genrnd/figa-pi.hw/README.md

figa-pi
======

figa-pi -- expansion board (HAT, hardware attached top) for Raspberry
PI with FPGA and 1G ethernet port.

Open hardware poject, made with Kicad.

Authors
-------

General RnD LLC, 2018, http://genrnd.com
