genrnd/figa-pi.hw/out/bom/figa-pi_bom.xls

Num | MF | MFPN | DESC | CAT | CASE | Quantity | Reference
1 | Yageo | CC0603KRX7R9BB104 | CAP CER 0.1UF 50V X7R 0603 | CAP | C0603 | 41 | C1 C10 C11 C12 C13 C14 C15 C16 C17 C18 C19 C2 C20 C21 C25 C3 C35 C36 C38 C39 C4 C41 C42 C43 C44 C45 C46 C47 C48 C5 C54 C56 C58 C60 C61 C63 C65 C66 C7 C8 C9
2 | Yageo | CC0603KRX5R7BB106 | CAP CER 10UF 16V X5R 0603 | CAP | C0603 | 14 | C22 C23 C24 C26 C27 C28 C29 C33 C34 C37 C40 C6 C62 C64
3 | Yageo | CC0603MRX5R6BB226 | CAP CER 22UF 10V X5R 0603 | CAP | C0603 | 3 | C30 C31 C32
4 | Yageo | CC0603KRX7R9BB103 | CAP CER 10000PF 50V X7R 0603 | CAP | C0603 | 7 | C49 C50 C52 C53 C55 C57 C59
5 | Ningbo connfly electronic | BH-10(IDC-10MS) | SHROUDED CONN TH 2x5pin 2.54mm | CONN | PIN_HEADER_SHR_2x5_2.54mm | 1 | J1
6 | Ningbo connfly electronic | PLS-2 | CONN TH 1x2pin 2.54mm | CONN | PIN_HEADER_1x2_2.54mm | 1 | J2
7 | Ningbo connfly electronic | PBD-40(DS1023-2x20) | CONN SOCKET TH 2x20pin 2.54mm | CONN | SOCKET_2x20_2.54mm | 1 | J3
8 | Ningbo connfly electronic | PLD-10(DS1021-2x5) | CONN TH 2x5pin 2.54mm | CONN | PIN_HEADER_2x5_2.54mm | 1 | J4
9 | Bel Fuse Inc | L829-1J1T-43 | CONN MAGJACK 1PORT 1000 BASE-T | CONN | L829_RJ45 | 1 | J5
10 | Ningbo connfly electronic | PBD-4 (DS1023-2X2) | CONN SOCKET TH 2x2pin 2.54mm | CONN | SOCKET_2x2_2.54mm | 1 | J6
11 | Murata Electronics | BLM21PG300SN1D | FERRITE BEAD 30 OHM 0805 1LN | IND | L0805 | 3 | L10 L11 L12
12 | Murata Electronics | BLM18PG330SN1D | FERRITE BEAD 33 OHM 0603 1LN | IND | L0603 | 10 | L1 L13 L14 L15 L16 L2 L3 L4 L5 L6
13 | Murata Electronics | LQH3NPN1R0MJRL | FIXED IND 1UH 1.62A 40 MOHM SMD | IND | L1212 | 3 | L7 L8 L9
14 | Yageo | RC0603FR-073K92L | RES SMD 3.92K OHM 1% 1/10W 0603 | RES | R0603 | 2 | R11 R12
15 | Yageo | RC0603FR-071KL | RES SMD 1k OHM 1% 1/10W 0603 | RES | R0603 | 7 | R10 R13 R18 R19 R20 R42 R8
16 | Yageo | RC0603FR-07390RL | RES SMD 390R OHM 1% 1/10W 0603 | RES | R0603 | 6 | R1 R2 R3 R4 R5 R6
17 | Yageo | RC0603FR-074K99L | RES SMD 4.99K OHM 1% 1/10W 0603 | RES | R0603 | 3 | R21 R22 R24
18 | Yageo | RC0603FR-07220RL | RES SMD 220R OHM 1% 1/10W 0603 | RES | R0603 | 2 | R28 R29
19 | Yageo | RC0603FR-07127KL | RES SMD 127k OHM 1% 1/10W 0603 | RES | R0603 | 1 | R30
20 | Yageo | RC0603FR-07178KL | RES SMD 178k OHM 1% 1/10W 0603 | RES | R0603 | 1 | R32
21 | Yageo | RC0603FR-0728KL | RES SMD 28k OHM 1% 1/10W 0603 | RES | R0603 | 3 | R31 R33 R35
22 | Yageo | RC0603FR-0746K4L | RES SMD 46.4k OHM 1% 1/10W 0603 | RES | R0603 | 1 | R34
23 | Yageo | RC0603FR-0733RL | RES SMD 33R OHM 1% 1/10W 0603 | RES | R0603 | 5 | R36 R37 R38 R39 R40
24 | Yageo | RC0603FR-0710KL | RES SMD 10k OHM 1% 1/10W 0603 | RES | R0603 | 10 | R14 R15 R16 R17 R23 R25 R26 R27 R7 R9
25 | Microchip Technology | 24LC32A/SN | IC EEPROM 32KBIT 400KHZ 8SOIC | IC | SOIC-8 | 1 | U1
26 | Texas Instruments | TLV62084DSGR | IC REG BUCK ADJ 2A SYNC 8WSON | IC | WSON-8 | 3 | U10 U11 U9
27 | Abracon LLC | ASEMB-25.000MHZ-LC-T | OSC MEMS 25.000MHZ CMOS SMD | IC | 4-SMD, No Lead | 1 | U2
28 | ON Semiconductor | NUP4114UPXV6T1G | TVS DIODE 5.5V 10V SOT563 | DIODE | SOT-563 | 1 | U3
29 | Intel | 10CL025ZE144 | FPGA | IC | QFP-144 | 1 | U5
30 | Microchip Technology | KSZ9021GN | IC TXRX ETHERNET 64QFN | IC | QFN-64 | 1 | U6
31 | Texas Instruments | CDCLVC1102PW | IC CLK BUFFER 1:2 250MHZ 8TSSOP | IC | TSSOP-8 | 1 | U7
32 | Kingbright | KP-1608SGC | SMD LED 0603 GREEN | DIODE | LED0603 | 3 | VD2 VD4 VD6
33 | Kingbright | KP-1608SRC | SMD LED 0603 RED | DIODE | LED0603 | 3 | VD1 VD3 VD5
