genrnd/figa-pi.hw/out/sch/figa-pi-sch.pdf

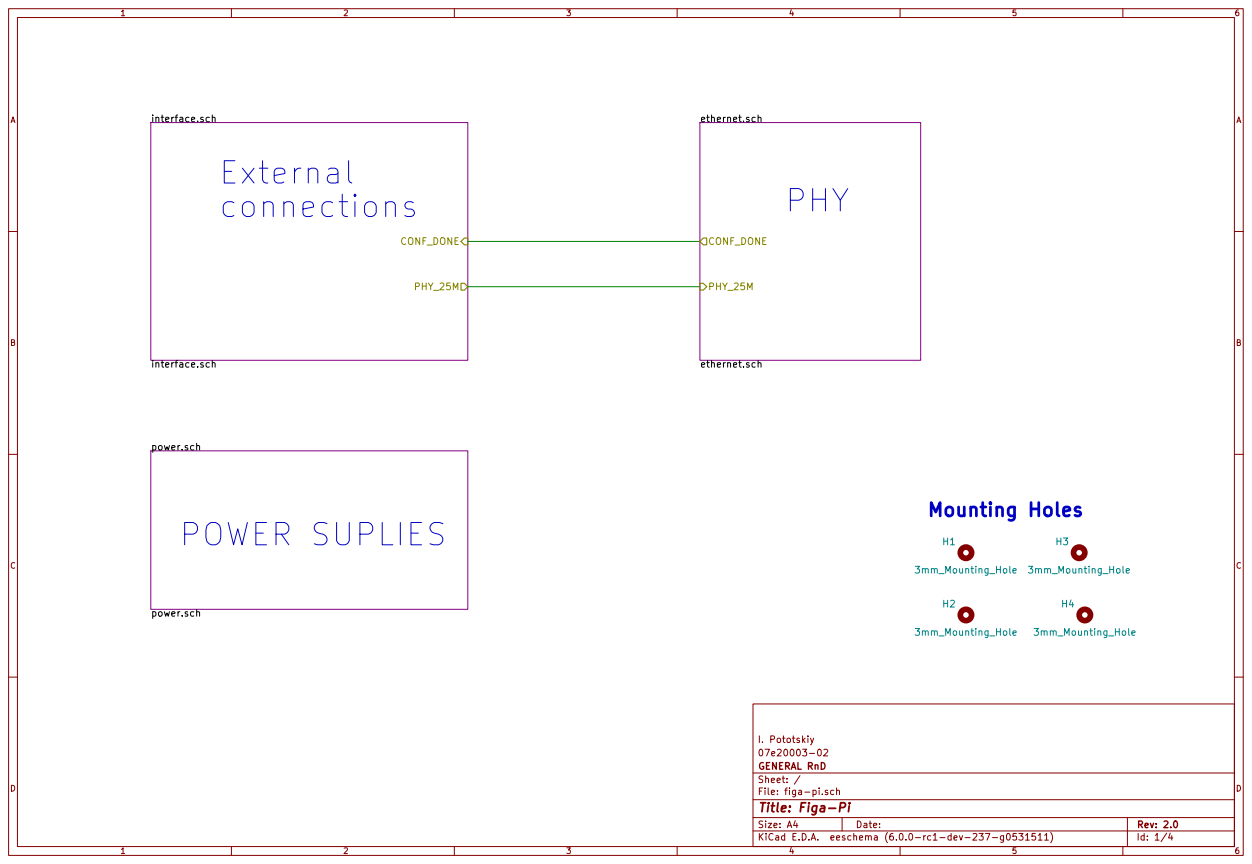
[picture p1: page 1]

File: figa-pi.sch Sheet: / GENERAL RnD

Id: 1/4 Title: Figa-Pi

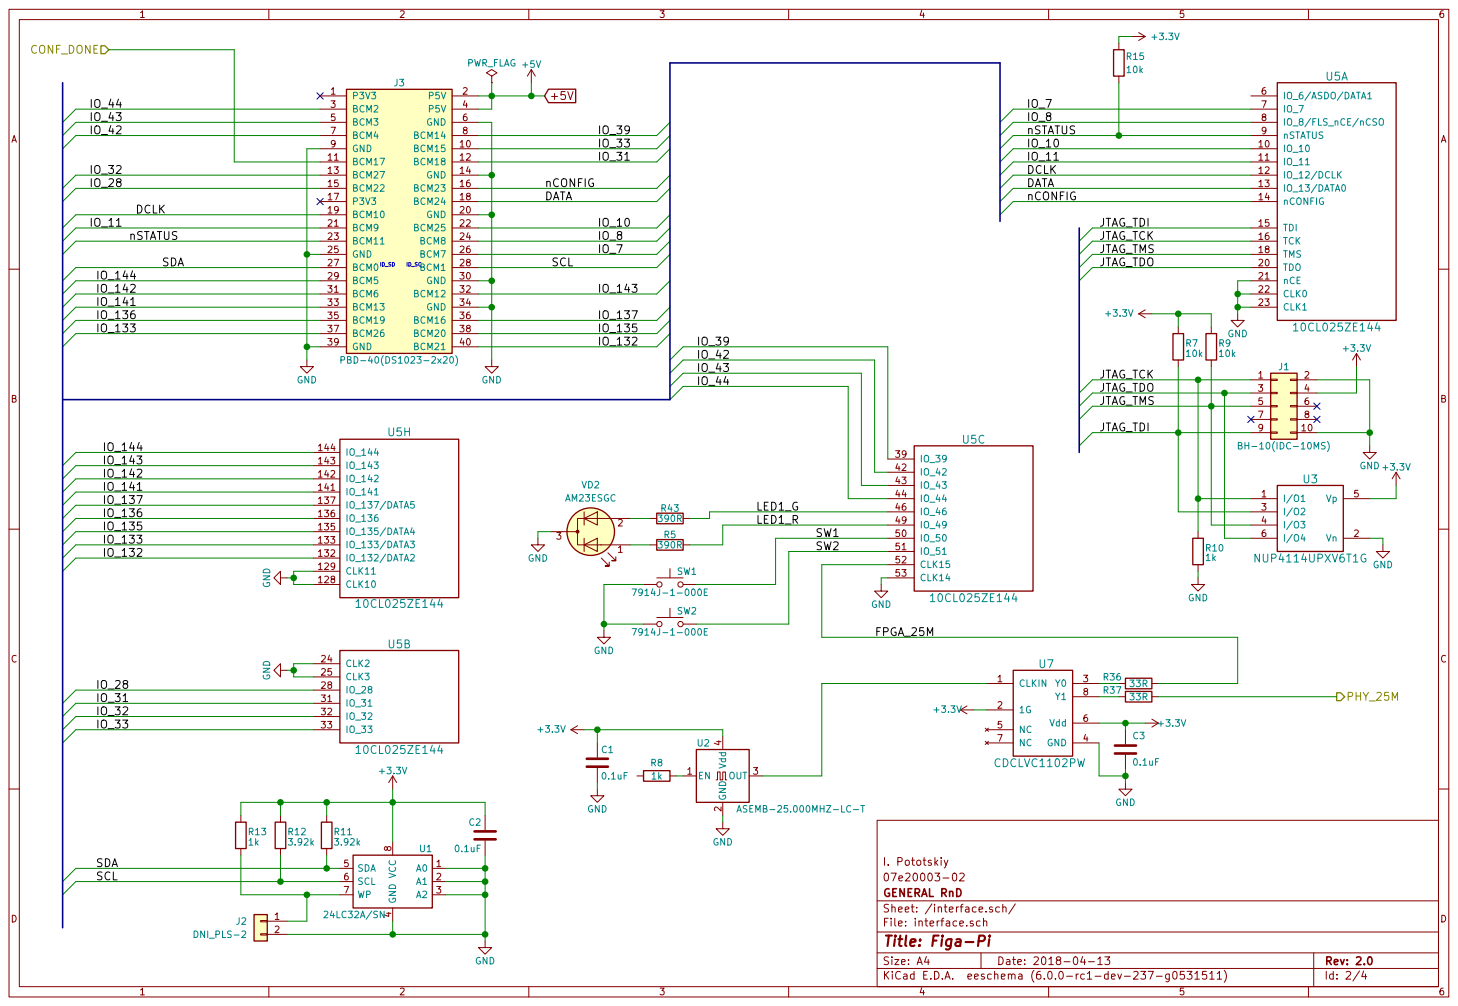
[picture p2: page 2]

IO_33 | IO_10
IO_31 | IO_11 | IO_11 11

IO_8
IO_7

IO_135
IO_132

J1 BH-10(IDC-10MS) GND GND

2 OUT 3 Vdd U2 4 ASEMB-25.000MHZ-LC-T R8

I. Pototskiy
Id: 2/4 Title: Figa-Pi File: interface.sch Sheet: /interface.sch/ GENERAL RnD

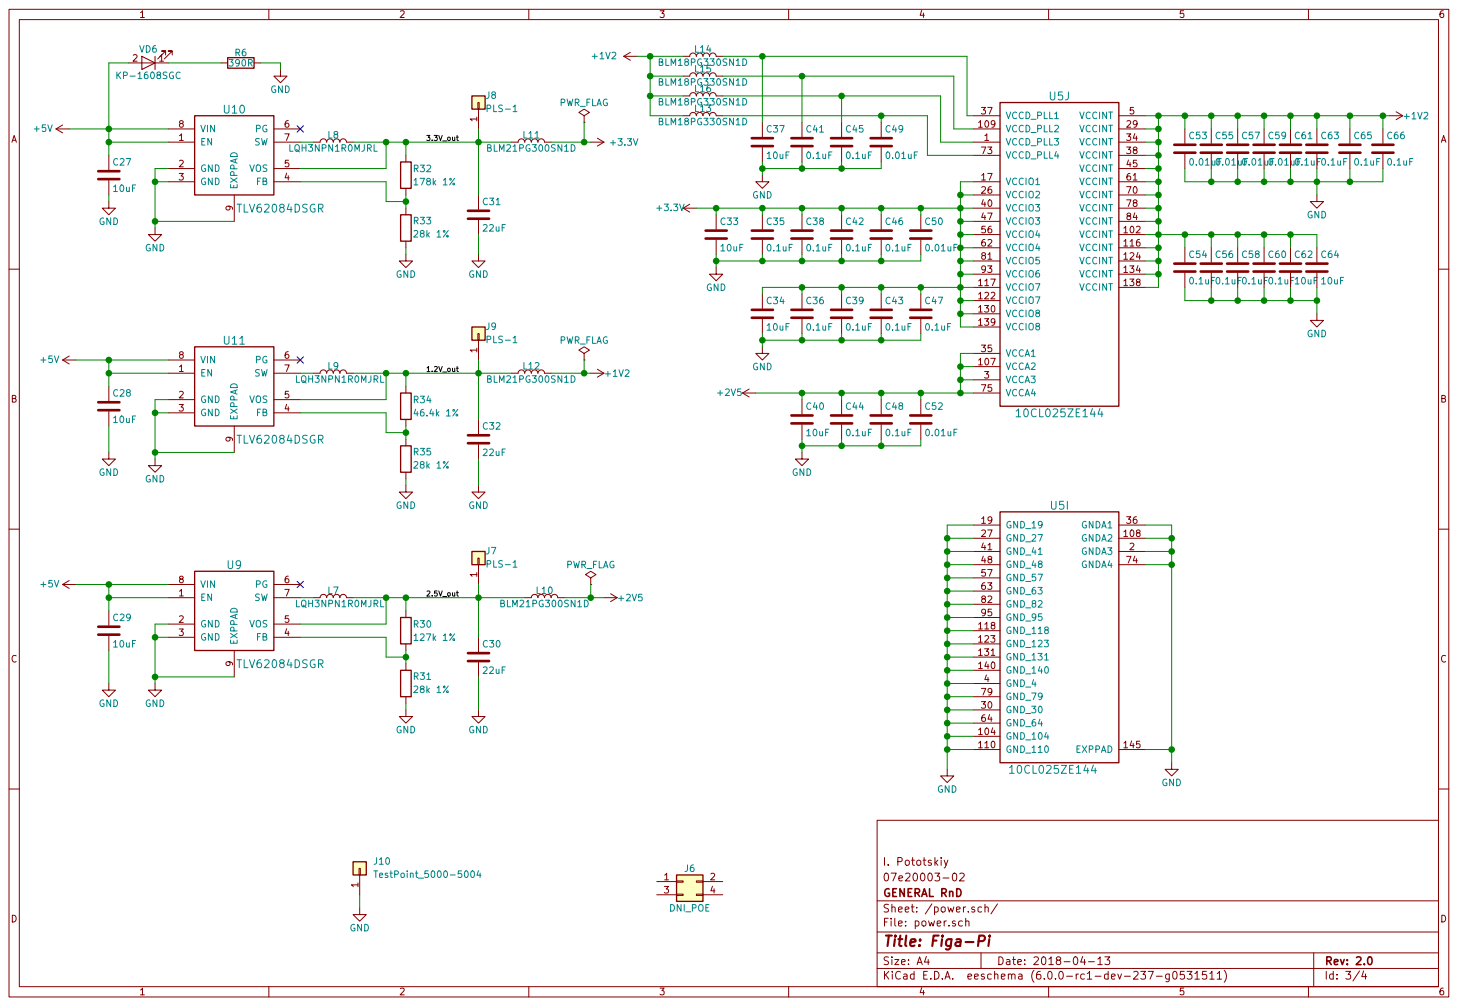
[picture p3: page 3]

Sheet: /power.sch/ GENERAL RnD

File: power.sch
Id: 3/4 Title: Figa-Pi

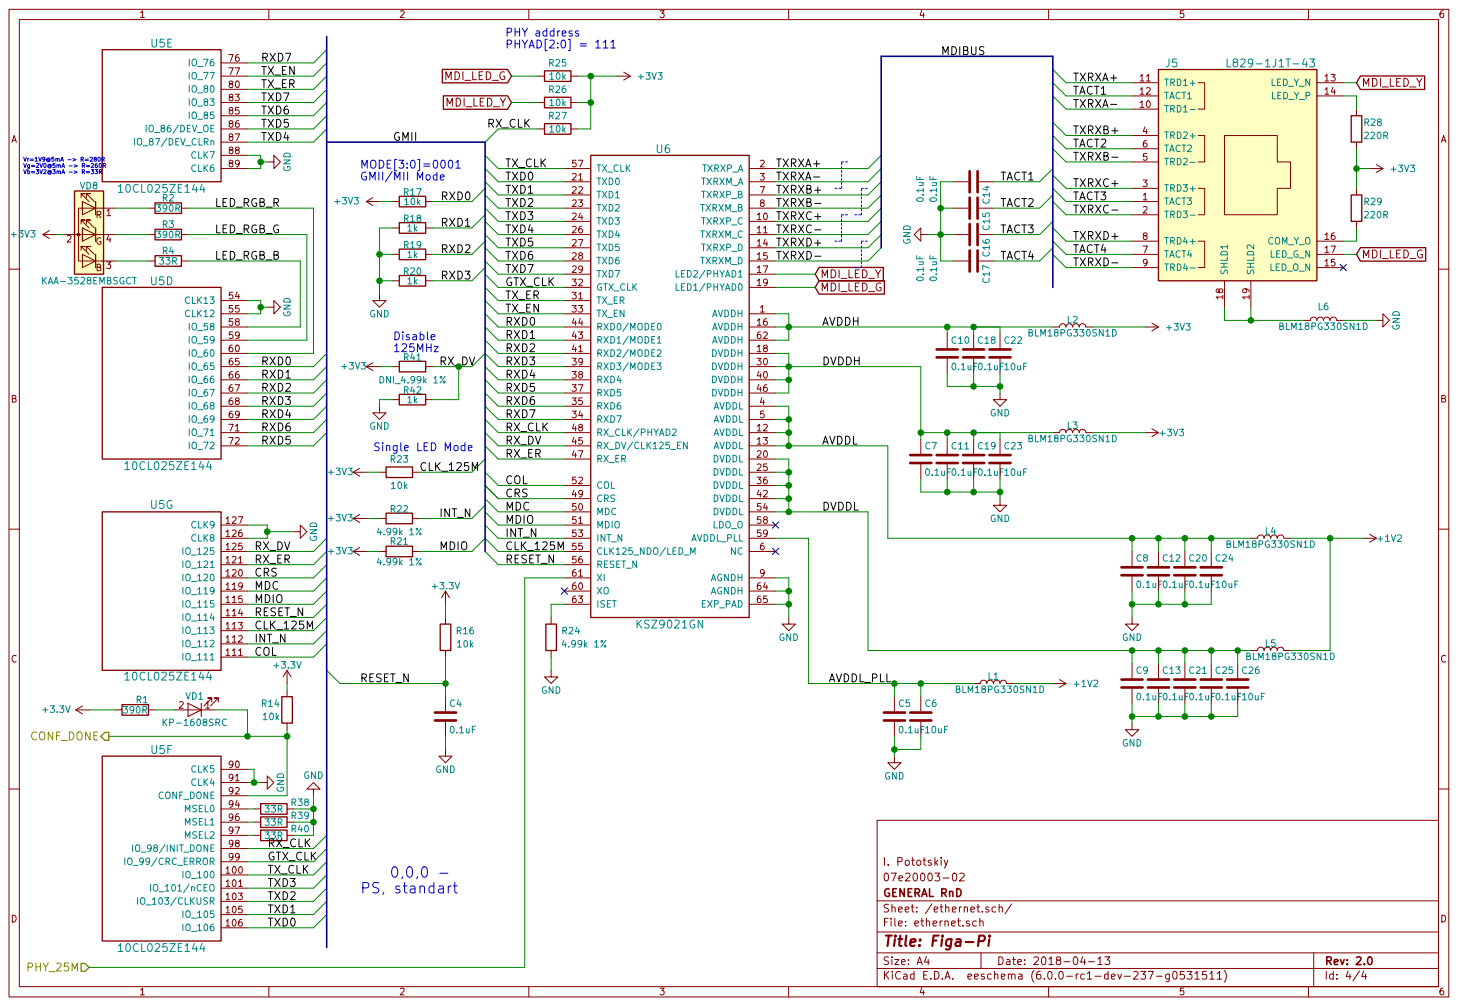
[picture p4: page 4]

TXRXA+ TXRXA- TXRXB+ TXRXB- TXRXC+

I. Pototskiy
Id: 4/4 Title: Figa-Pi File: ethernet.sch Sheet: /ethernet.sch/ GENERAL RnD
