genrnd/figa-pi.hw/out/assy/figa-pi-assy_bot.pdf

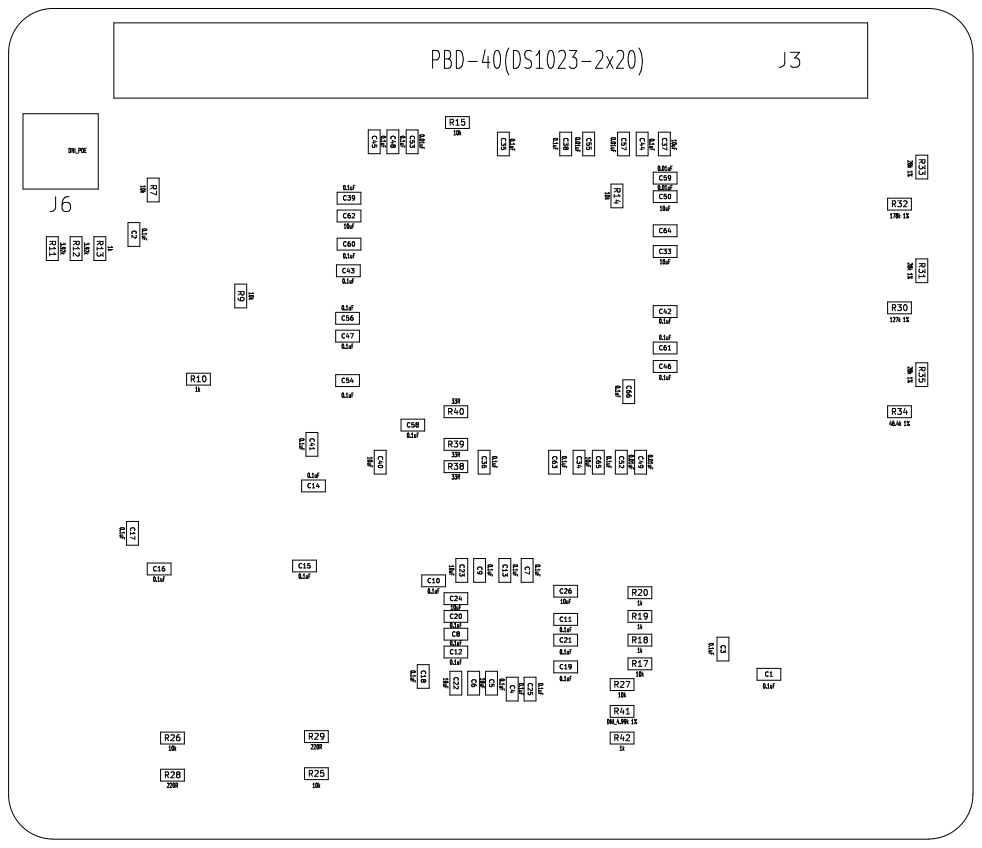
[picture p5: page 1]
