genrnd/figa-pi.hw/out/assy/figa-pi-assy_top.pdf

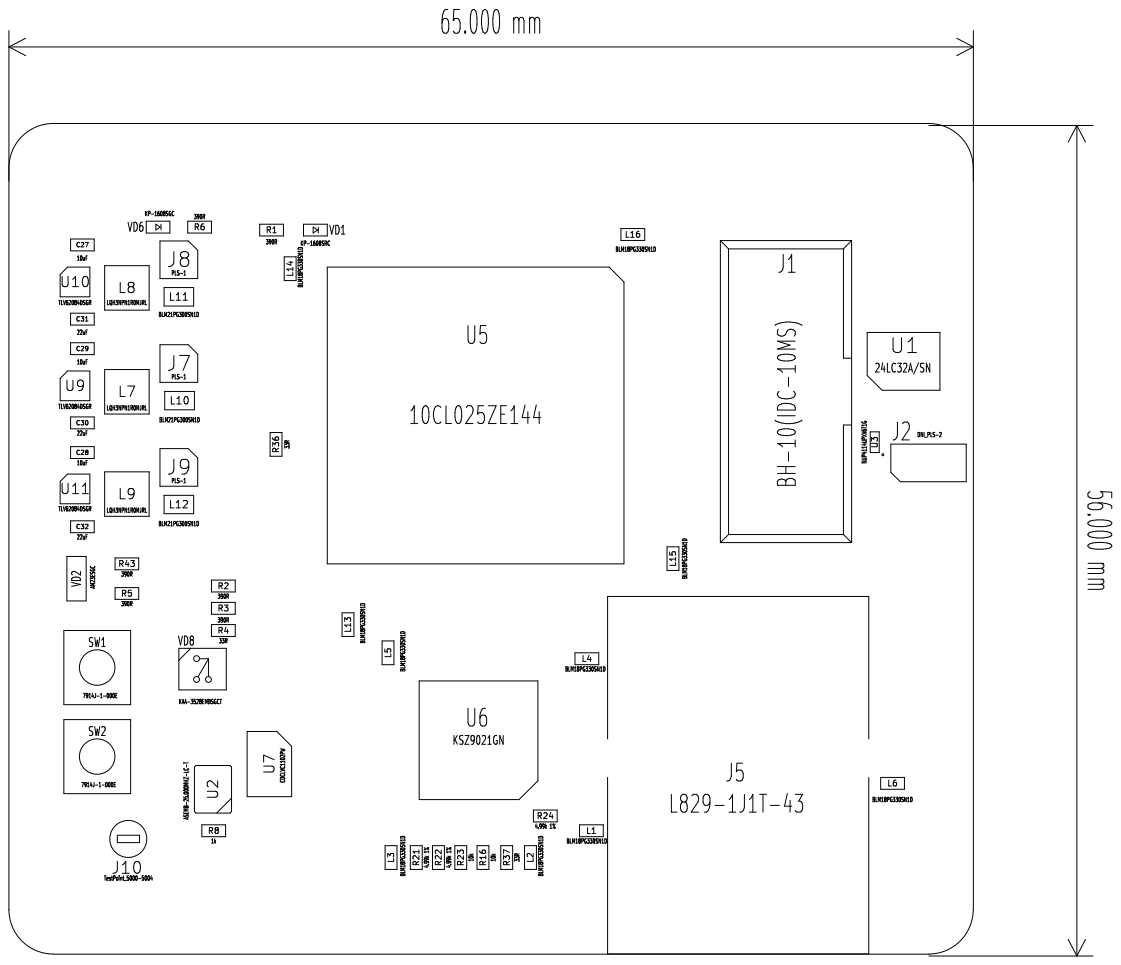
[picture p6: page 1]
