genrnd/figa-pi.hw/(commit log)

2018-04-04 add kicad folder
2018-04-04 init project
    [fpgagigepi.kicad_pcb, fpgagigepi.sch]
2018-04-06 add components to library. start electric schematic
    [ethernet.sch, interface.sch, power.sch]
2018-04-13 add ksz9021gn, cfps-73 to library
    [ethernet.sch, fpgagigepi.sch, interface.sch, power.sch]
2018-04-16 add tlv62080 to library, continue design schematic
    [ethernet.sch, fpgagigepi.sch, interface.sch, power.sch]
2018-04-17 add nb3l553dr2g to library, continue design schematic
    [ethernet.sch, fpgagigepi.sch, interface.sch, power.sch]
2018-04-18 continue design schematic
    [ethernet.sch, interface.sch, power.sch]
2018-04-20 finished electrical connections
    [ethernet.sch, interface.sch, power.sch]
2018-05-22 write nominal of components
    [ethernet.sch, fpgagigepi.kicad_pcb, interface.sch, power.sch]
2018-05-23 place components to pcb, add footprints of cfps-73 l829 sot-563
    [ethernet.sch, fpgagigepi.kicad_pcb, interface.sch, power.sch]
2018-05-24 add modeles to 3d render
    [ethernet.sch, fpgagigepi.kicad_pcb, interface.sch, power.sch]
2018-05-25 remove CR (carriage return) from README
2018-05-29 Project translated to template "Raspberry Pi HAT" Added library files from template. Renamed refdes. Changed placement for all components
    [ethernet.sch, fpgagigepi.kicad_pcb, fpgagigepi.sch, interface.sch, power.sch]
2018-05-30 Update path to 3d models for components in local library (add ${KIPRJMOD}/packages3d/)
    [fpgagigepi.kicad_pcb]
2018-06-01 Schematics updated for correct BOM generation Corrected RefDes (not renumbered yet) PCB updated (not routed) Added 3d models for new components Added folder assy (empty) Added folder bom Added BOM fi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
    [ethernet.sch, fpgagigepi.kicad_pcb, interface.sch, power.sch]
2018-06-05 Corrected path for schematics Renumbered components Remaped GMII connections to other banks PCB updated - final placement for major components and some conn routed Corrected 3d models Add text Cyclon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
    [BOM_fpgagigepi.xls, ethernet.sch, fpgagigepi.kicad_pcb, fpgagigepi.sch, interface.sch, power.sch]
2018-06-06 Replaced clock buffer NB3L553DR2G to cdclvc1102 Added datasheet for cdclvc1102 Added components cdclvc1102pw in library_cache Remaped cyclone-to-40-pin-header connections Updated schematics Updated P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
    [BOM_fpgagigepi.xls, ethernet.sch, fpgagigepi.kicad_pcb, interface.sch, power.sch]
2018-06-08 rename project files to figa-pi and internal text replaced to figa-pi
    [ethernet.sch, figa-pi.kicad_pcb, figa-pi.sch, interface.sch, power.sch]
2018-06-08 Added LOGO as footprint Added fields for all components Renamed BOM file. Updated BOM file. Updated project fields.
    [BOM_fpgagigepi.xls, ethernet.sch, figa-pi.kicad_pcb, figa-pi.sch, figa-pi_bom.xls, interface.sch, power.sch]
2018-06-09 Removed datasheet for unused components Removed library for single components Create common symbol library for project figa-pi.lib Updated path to new symbol library
    [ethernet.sch, figa-pi.sch, interface.sch, power.sch]
2018-06-09 Removed footprint for unused components Updated 3d model for LQFP-144 Updated symbol library Updated schematics Updated PCB - finished routing
    [ethernet.sch, figa-pi.kicad_pcb, figa-pi.sch, interface.sch, power.sch]
2018-06-10 add board name to pcb (figa-pi), move board number and correct company name
    [figa-pi.kicad_pcb]
2018-06-10 remove company name. url is more than enough
    [figa-pi.kicad_pcb]
2018-06-13 Added logo as 2 footprints Corrected RefDes dimensions and placement on silk layers
    [figa-pi.kicad_pcb]
2018-06-13 Updated Logo footprint Updated PCB with new footprint
    [figa-pi.kicad_pcb]
2018-06-19 Updated BOM file Added footprint for Logo
    [figa-pi_bom.xls]
2018-06-19 Updated PCB for manufacturing Created assembly drawings (without title) Created gerbers and drilling files
    [figa-pi-B.Cu.gbr, figa-pi-B.Mask.gbr, figa-pi-B.Paste.gbr, figa-pi-B.SilkS.gbr, figa-pi-Edge.Cuts.gbr, figa-pi-F.Cu.gbr, figa-pi-F.Mask.gbr, figa-pi-F.Paste.gbr]
2018-06-20 Updated PCB for manufacturer "Rezonit" tech parameters Updated gerber and drill files Updated assembly drawing files Created mf_pcb folder Added files for manufacturer "Rezonit"
    [Rezonit_blank.xls, StackUp_4Layers.xls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]
2018-06-21 Replaced L7,L8,L9 (LQH3NPN1R0NJ0 - obsolete) with LQH3NPN1R0MJRL Updated project files Updated BOM file
    [figa-pi.kicad_pcb, figa-pi_bom.xls, power.sch]
2018-06-22 Updated top silk layer with power signals marking Updated one gerber file figa-pi-F.SilkS.gbr
    [figa-pi.kicad_pcb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]
2018-06-25 add schematic pdf to repo
2018-07-24 Updated footprint and 3D model for ksz9021gn (it was wrong)
    [ethernet.sch, figa-pi.kicad_pcb]
2018-07-27 Add datasheets for new components (Leds, Button, TestPoint) Add 3D models for new components (Leds, Button, TestPoint) Add footprints for new components (Leds, Button, TestPoint) Add new components t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
    Schematic changes:
    Change revision 1.0 -> 2.0
    Add dual-color and RGB leds. Connect to FPGA.
    Add tespoint for GND connection.
    Add 2 tactile smd button. Connect to FPGA.
    Remove User Gpio Header.
    Reconnect FPGA-to-Raspberry connections
    PCB changes:
    Change revision 1.0 -> 2.0
    Rotate RJ-45 connector
    Remove text REF around fidusial.
    Place new components (Leds, Button, TestPoint)
    All connections routed
    DRC ok (one error for fidusial)
    [ethernet.sch, figa-pi.kicad_pcb, figa-pi.sch, interface.sch, power.sch]
2018-07-31 Update footprints Update pcb Update pdf shematics Generate assy drawing Generate gerbers and drills files Delete order_blank and archive with gerbers for Rezonit
    [Rezonit_blank.xls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]
2018-08-01 Add files for manufacturer Rezonit
    [Rezonit_blank.xls]
2018-08-11 Add path for 3d model for PHY chip
    [figa-pi.kicad_pcb]
2018-09-14 change pdf schematic to color version
